oresk/multi_new/GFCI_sensor_pcb/PXL_20240924_142343800.jpg

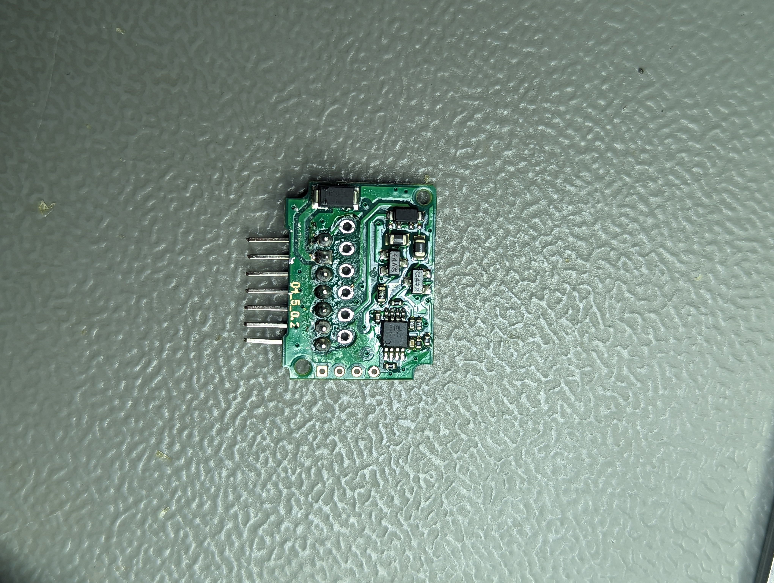
GFCI_sensor_pcb/PXL_20240924_142343800.jpg
