oresk/multi_new/GFCI_sensor_pcb/PXL_20240924_140607482.jpg

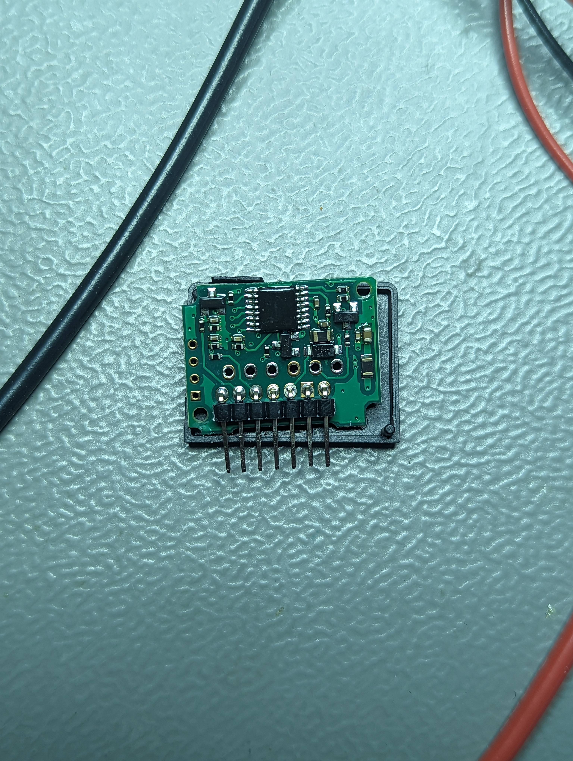
GFCI_sensor_pcb/PXL_20240924_140607482.jpg
