oresk/multi_new/GFCI_sensor_pcb/PXL_20240924_142329196.jpg

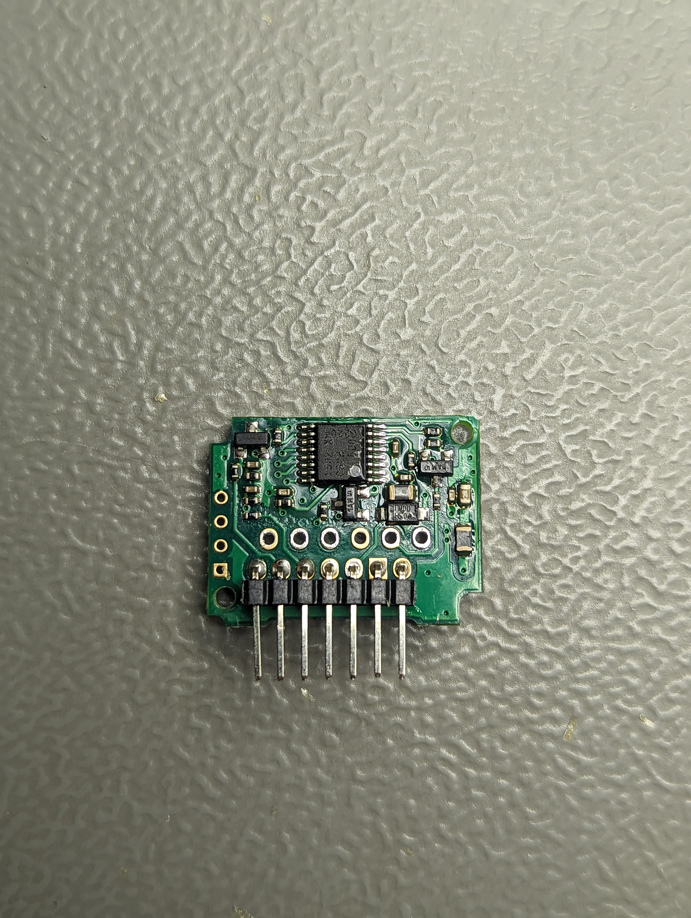
GFCI_sensor_pcb/PXL_20240924_142329196.jpg
