oresk/multi_new/code/hw_lower_v2/hw_lower_v2/hw_lower_v2.kicad_pcb

## KiCad design code/hw_lower_v2/hw_lower_v2/hw_lower_v2.kicad_pcb (2024-10-02)

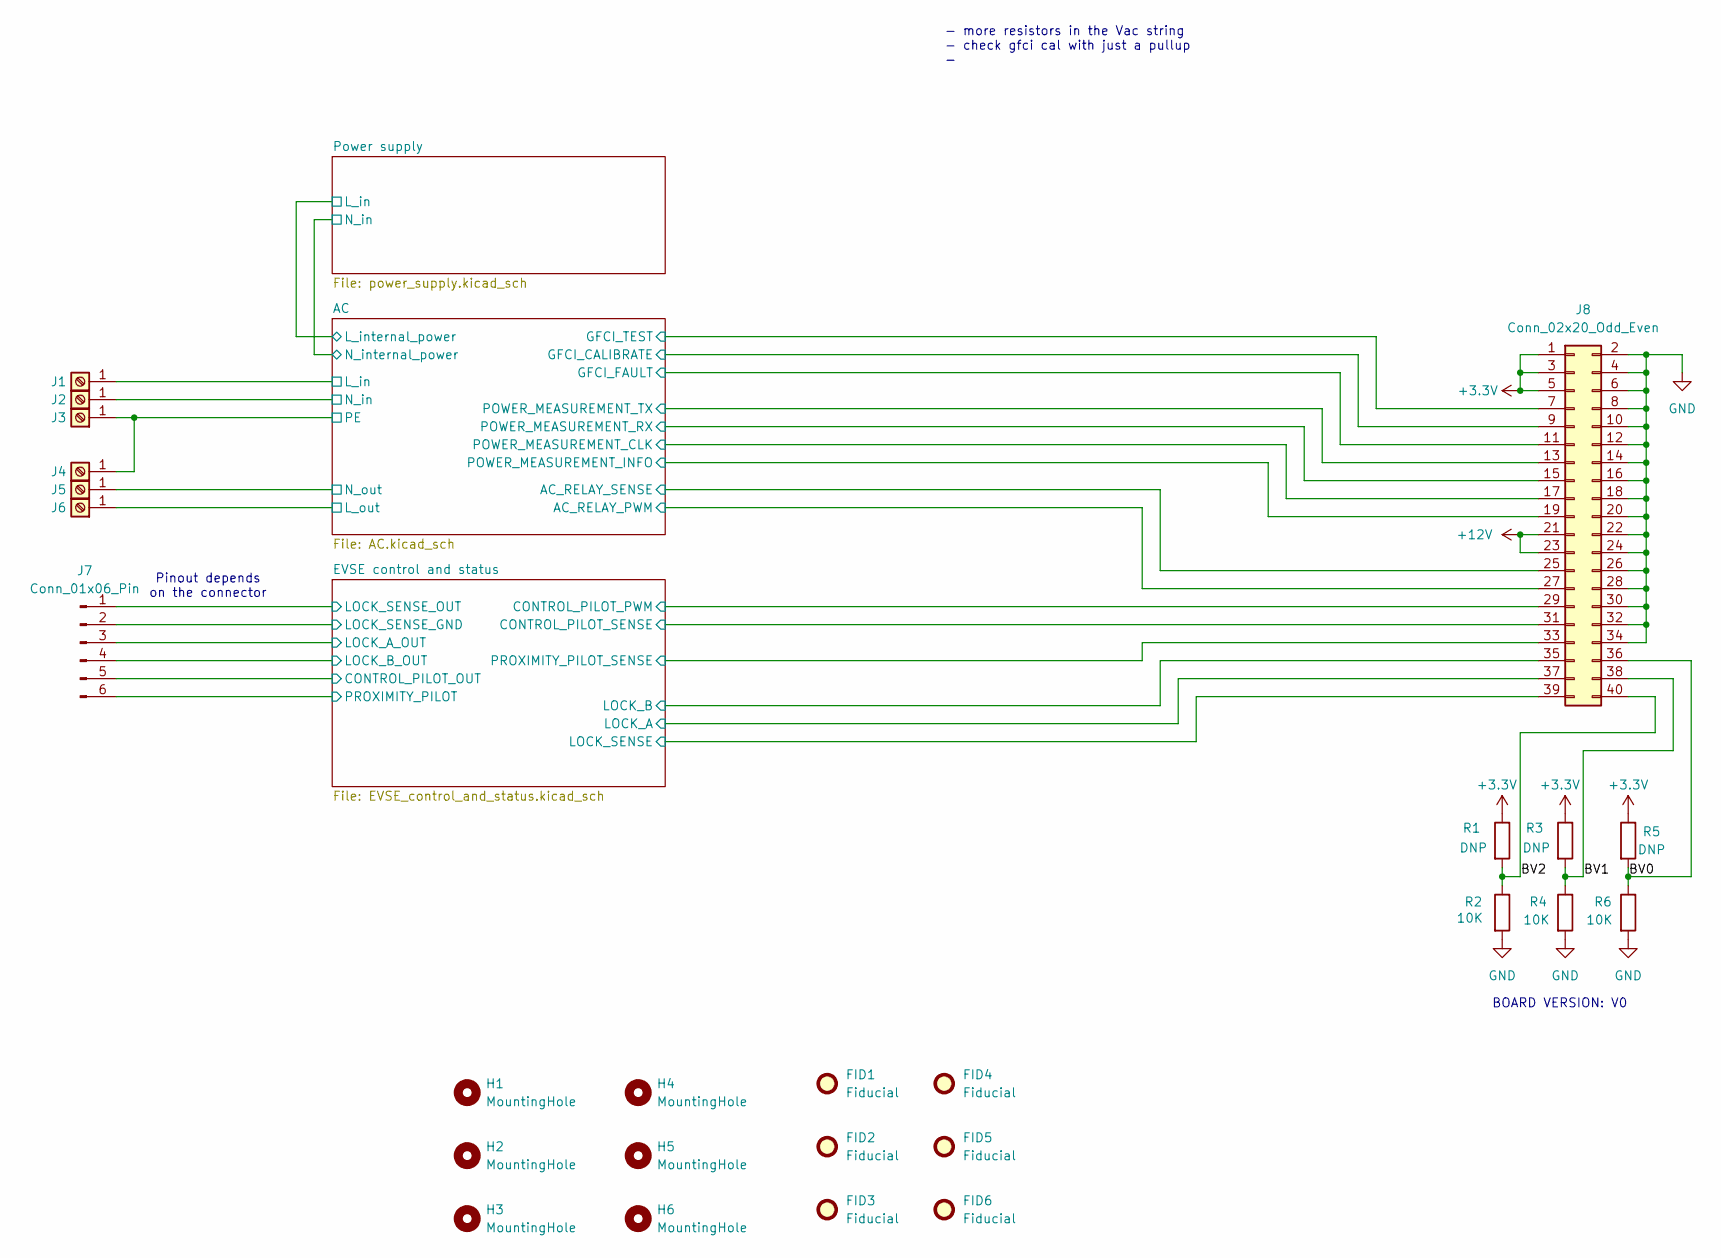
[picture p22: schematic hw_lower_v2.kicad_sch, BlueEVSE]

Parts:
FID1, FID2, FID3, FID4, FID5, FID6: Fiducial; Fiducial_1mm_Mask3mm
H1, H2: MountingHole; MountingHole_3.2mm_M3
H3, H4, H5, H6: MountingHole; MountingHole_3.2mm_M3_Pad
J1, J2, J3, J4, J5, J6: Screw_Terminal_01x01; CONN-TH_T44001; LCSC C481447
J7: Conn_01x06_Pin; PinHeader_1x06_P2.54mm_Horizontal; LCSC C56816
J8: Conn_02x20_Odd_Even; PinHeader_2x20_P2.54mm_Vertical
R1, R3, R5: DNP; R_0603_1608Metric
R2, R4, R6: 10K; R_0603_1608Metric; LCSC C25804

Connections:
+12V: J8.21, J8.23; also elsewhere on the board
/AC/AC_RELAY_PWM: J8.27; also elsewhere on the board
/AC/AC_RELAY_SENSE: J8.25; also elsewhere on the board
/AC/GFCI_CALIBRATE: J8.9; also elsewhere on the board
/AC/GFCI_FAULT: J8.11; also elsewhere on the board
/AC/GFCI_TEST: J8.7; also elsewhere on the board
/AC/L_in: J1.1; also elsewhere on the board
/AC/L_out: J6.1; also elsewhere on the board
/AC/N_in: J2.1; also elsewhere on the board
/AC/N_out: J5.1; also elsewhere on the board
/AC/POWER_MEASUREMENT_CLK: J8.17; also elsewhere on the board
/AC/POWER_MEASUREMENT_INFO: J8.19; also elsewhere on the board
/AC/POWER_MEASUREMENT_RX: J8.15; also elsewhere on the board
/AC/POWER_MEASUREMENT_TX: J8.13; also elsewhere on the board
/BV0: J8.36, R5.2, R6.1
/BV1: J8.38, R3.2, R4.1
/BV2: J8.40, R1.2, R2.1
/EVSE control and status/CONTROL_PILOT_OUT: J7.5; also elsewhere on the board
/EVSE control and status/CONTROL_PILOT_PWM: J8.29; also elsewhere on the board
/EVSE control and status/CONTROL_PILOT_SENSE: J8.31; also elsewhere on the board
/EVSE control and status/LOCK_A: J8.37; also elsewhere on the board
/EVSE control and status/LOCK_A_OUT: J7.3; also elsewhere on the board
/EVSE control and status/LOCK_B: J8.35; also elsewhere on the board
/EVSE control and status/LOCK_B_OUT: J7.4; also elsewhere on the board
/EVSE control and status/LOCK_SENSE: J7.1, J8.39; also elsewhere on the board
/EVSE control and status/PROXIMITY_PILOT: J7.6, J8.33; also elsewhere on the board
Earth_Protective: J3.1, J4.1

Notes on the sheet:
BOARD VERSION: V0
Pinout depends on the connector
- more resistors in the Vac string - check gfci cal with just a pullup -

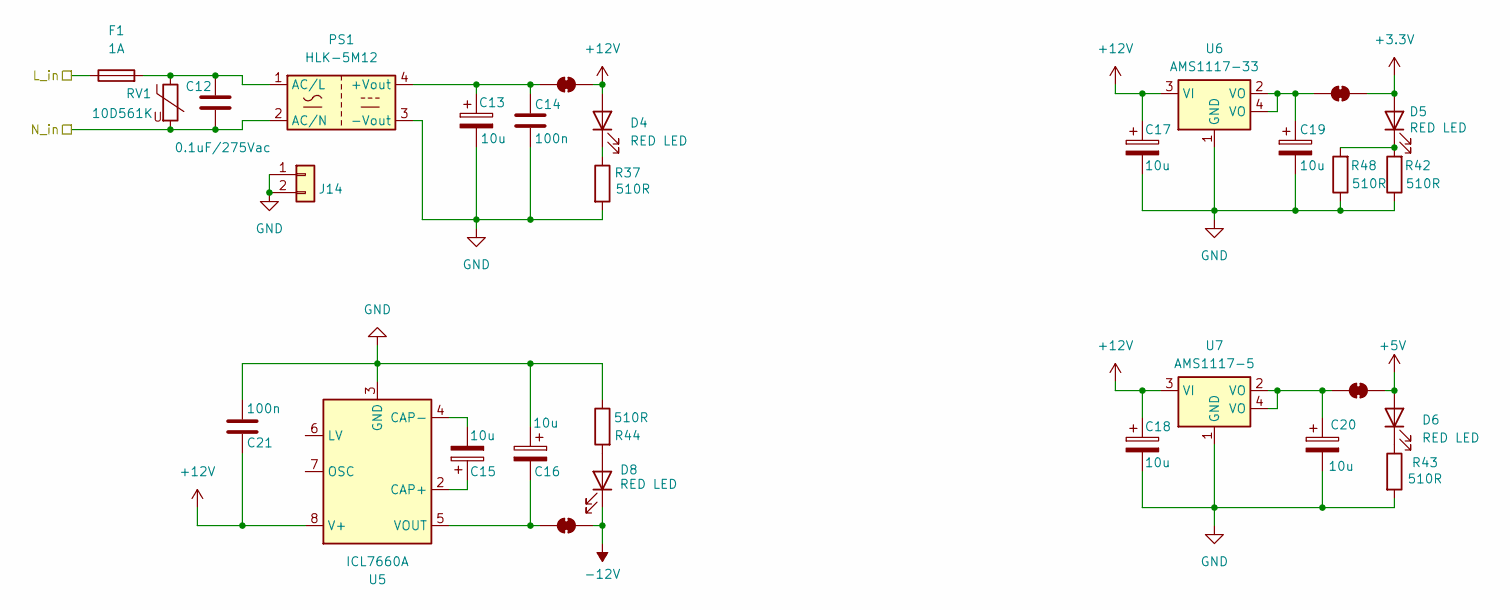
[picture p23: schematic power_supply.kicad_sch, BlueEVSE]

Parts:
C12: 0.1uF/275Vac; CAP-TH_L13.0-W6.0-P10.00-D0.6; LCSC C489079
C13, C15, C16, C17, C18, C19, C20: 10u; CP_Elec_4x5.4; LCSC C86602
C14, C21: 100n; C_0805_2012Metric; LCSC C327162
D4, D5, D6, D8: RED LED; D_0603_1608Metric; LCSC C7496820
F1: 1A; F1206; LCSC C910830
J14: Conn_01x02; PinHeader_1x02_P2.54mm_Vertical
JP1, JP3, JP4, JP5: SolderJumper_2_Bridged; SolderJumper-2_P1.3mm_Bridged2Bar_RoundedPad1.0x1.5mm
PS1: HLK-5M12; Converter_ACDC_Hi-Link_HLK-5Mxx; LCSC C209908
R37, R42, R43, R44, R48: 510R; R_0603_1608Metric; LCSC C23193
RV1: 10D561K; RES-TH_L12.5-W4.4-P7.50-D0.8-S3.60; LCSC C2761663
U5: ICL7660A; SOIC-8_L5.0-W4.0-P1.27-LS6.0-BL; LCSC C7881
U6: AMS1117-33; SOT-223_L6.7-W3.5-P2.30-BR; LCSC C6186
U7: AMS1117-5; SOT-223_L6.7-W3.5-P2.30-BR; LCSC C6187

Connections:
+12V: C17.1, C18.1, C21.1, D4.2 (A), JP1.1 (A), U5.8 (V+), U6.3 (VI), U7.3 (VI); also elsewhere on the board
/AC/L_internal_power: F1.1; also elsewhere on the board
/AC/N_internal_power: C12.2, PS1.2 (AC/N), RV1.2; also elsewhere on the board
unnamed: D4.1 (K), R37.1
unnamed: D5.1 (K), R42.2, R48.2
unnamed: D6.1 (K), R43.1
unnamed: D8.2 (A), R44.2
unnamed: C13.1, C14.1, JP1.2 (B), PS1.4 (+Vout)
unnamed: C16.2, JP3.2 (B), U5.5 (VOUT)
unnamed: C19.1, JP4.2 (B), U6.2 (VO), U6.4 (VO)
unnamed: C20.1, JP5.2 (B), U7.2 (VO), U7.4 (VO)
unnamed: C12.1, F1.2, PS1.1 (AC/L), RV1.1
unnamed: C15.1, U5.2 (CAP+)
unnamed: C15.2, U5.4 (CAP-)

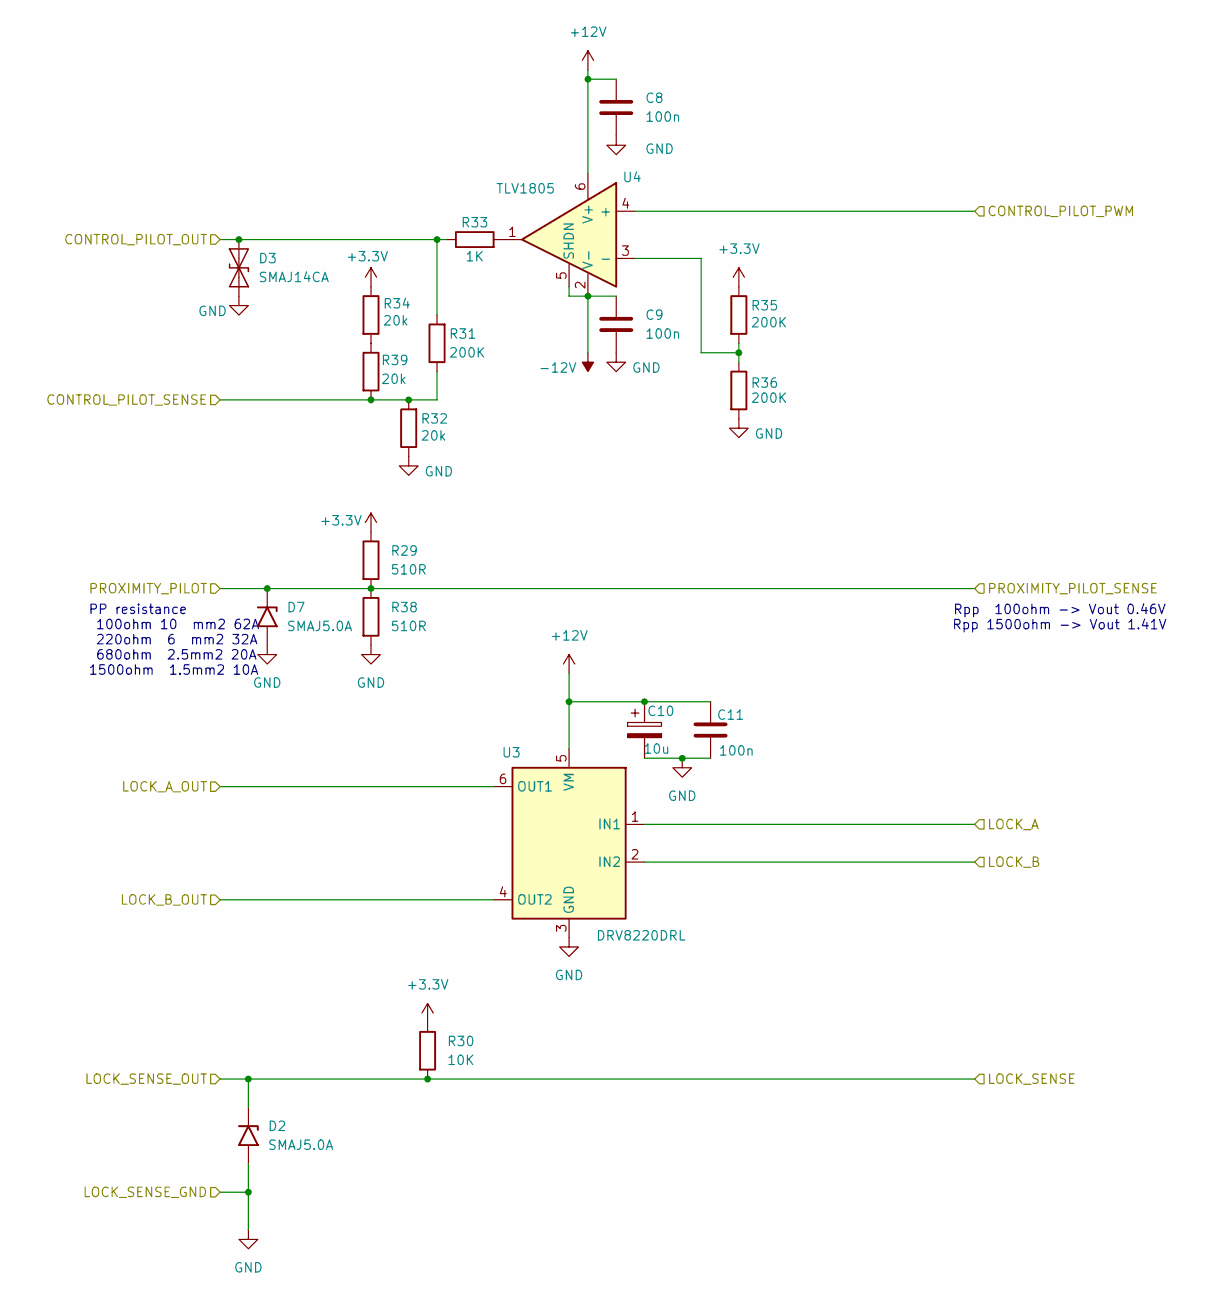
[picture p24: schematic EVSE_control_and_status.kicad_sch, BlueEVSE]

Parts:
C8, C9, C11: 100n; C_0805_2012Metric; LCSC C327162
C10: 10u; CP_Elec_4x5.4; LCSC C86602
D2, D7: SMAJ5.0A; D_SMA; LCSC C7473307
D3: SMAJ14CA; D_SMA; LCSC C908820
R29, R38: 510R; R_0603_1608Metric; LCSC C23193
R30: 10K; R_0603_1608Metric; LCSC C25804
R31, R35, R36: 200K; R_0603_1608Metric; LCSC C2989567
R32, R34, R39: 20k; R_0603_1608Metric
R33: 1K; R_0603_1608Metric
U3: DRV8220DRL; SOT-563; LCSC C3681351
U4: TLV1805; SOT-23-6_L2.9-W1.6-P0.95-LS2.8-BR; LCSC C2862164

Connections:
+12V: C8.1, C10.1, C11.1, U3.5 (VM), U4.6 (V+); also elsewhere on the board
/EVSE control and status/CONTROL_PILOT_OUT: D3.2 (A2), R31.2, R33.1; also elsewhere on the board
/EVSE control and status/CONTROL_PILOT_PWM: U4.4 (+); also elsewhere on the board
/EVSE control and status/CONTROL_PILOT_SENSE: R31.1, R32.2, R39.2; also elsewhere on the board
/EVSE control and status/LOCK_A: U3.1 (IN1); also elsewhere on the board
/EVSE control and status/LOCK_A_OUT: U3.6 (OUT1); also elsewhere on the board
/EVSE control and status/LOCK_B: U3.2 (IN2); also elsewhere on the board
/EVSE control and status/LOCK_B_OUT: U3.4 (OUT2); also elsewhere on the board
/EVSE control and status/LOCK_SENSE: D2.1 (A1), R30.2; also elsewhere on the board
/EVSE control and status/PROXIMITY_PILOT: D7.1 (A1), R29.2, R38.1; also elsewhere on the board
unnamed: R33.2, U4.1
unnamed: R34.2, R39.1
unnamed: R35.2, R36.1, U4.3 (-)

Notes on the sheet:
PP resistance 100ohm 10 mm2 62A 220ohm 6 mm2 32A 680ohm 2.5mm2 20A 1500ohm 1.5mm2 10A
Rpp 100ohm -> Vout 0.46V Rpp 1500ohm -> Vout 1.41V

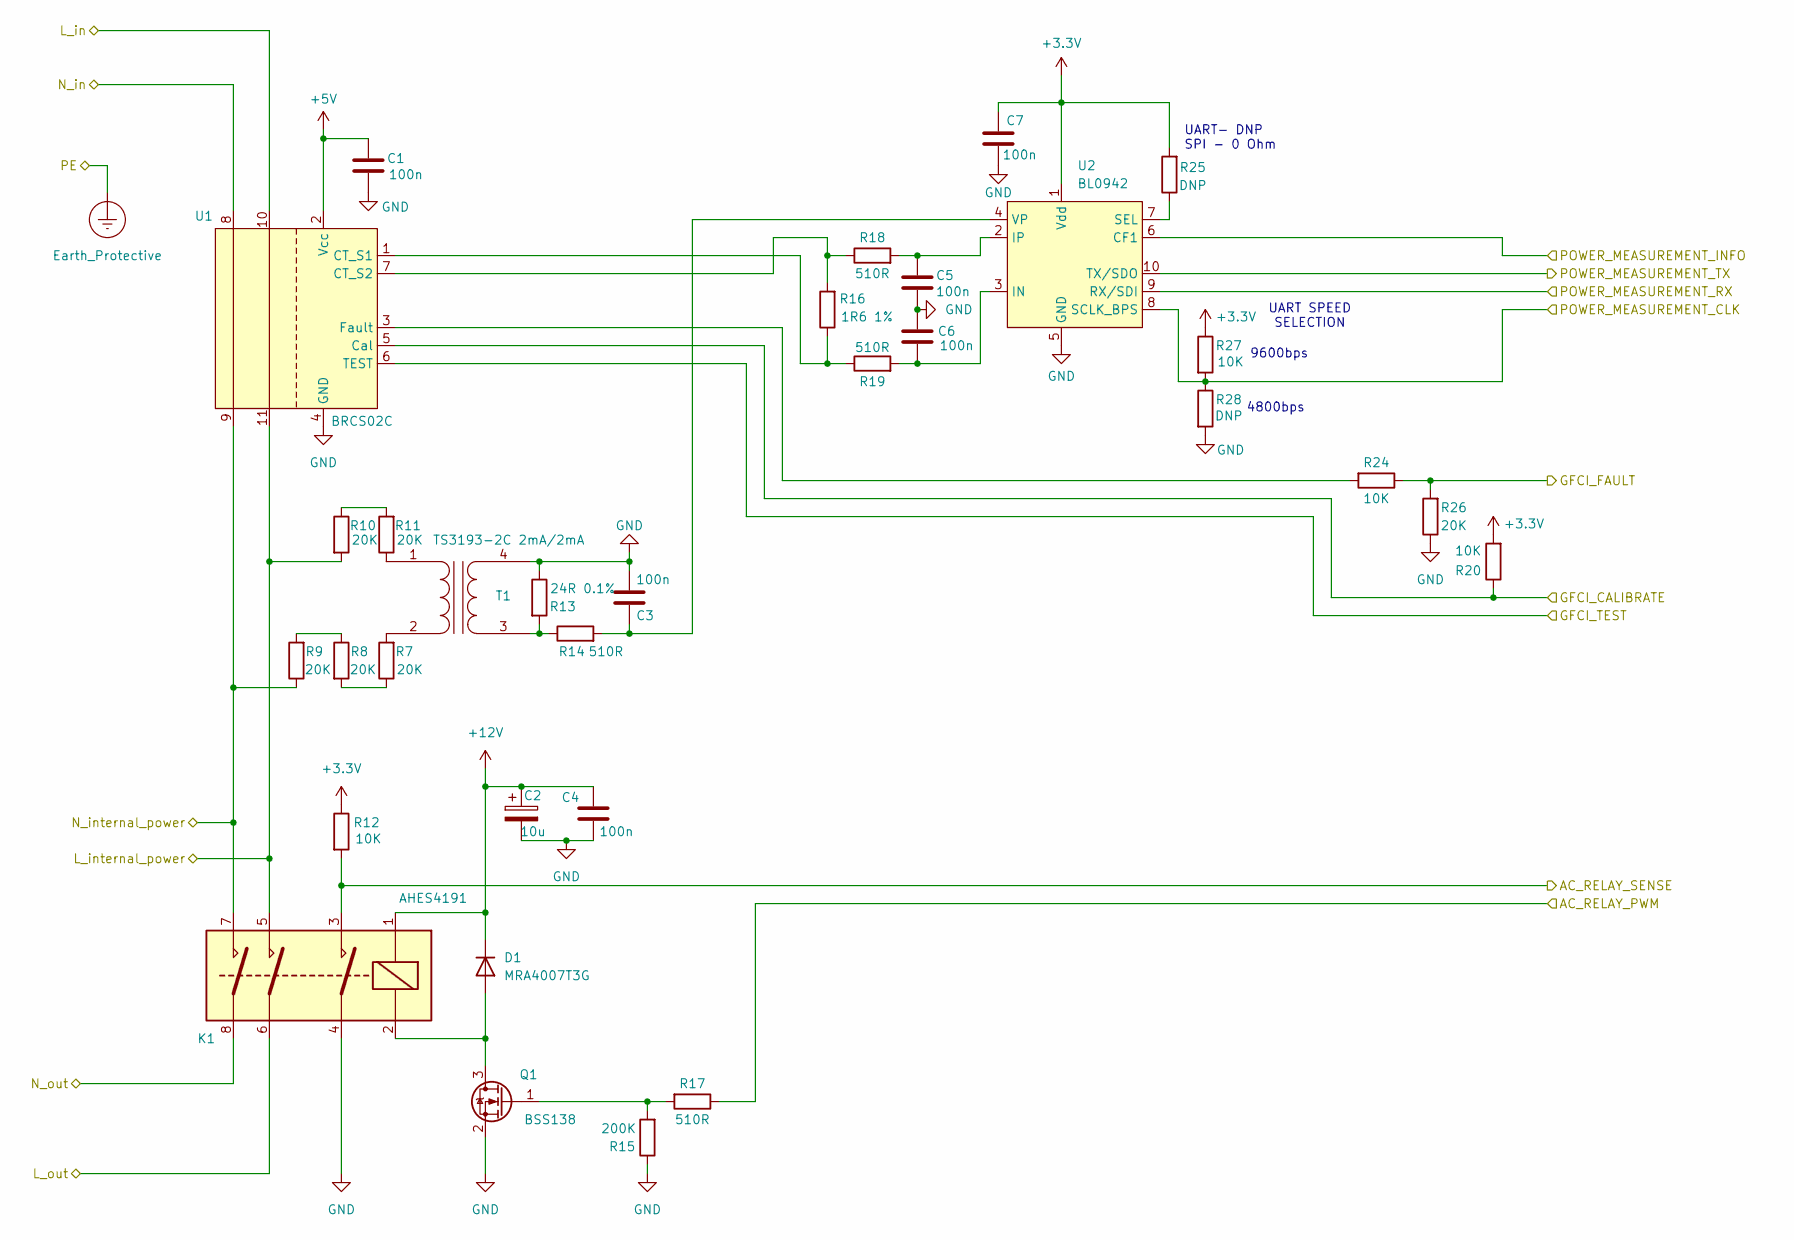
[picture p25: schematic AC.kicad_sch, BlueEVSE]

Parts:
C1, C3, C4, C5, C6, C7: 100n; C_0805_2012Metric; LCSC C327162
C2: 10u; CP_Elec_4x5.4; LCSC C86602
D1: MRA4007T3G; D_SMA; LCSC C47921
K1: AHES4191; panasonic HE-s; LCSC C719192
Q1: BSS138; SOT-23; LCSC C112239
R7, R8, R9, R10, R11, R26: 20K; R_1206_3216Metric; LCSC C706407
R12, R20, R24, R27: 10K; R_0603_1608Metric; LCSC C25804
R13: 24R 0.1%; R_0603_1608Metric; LCSC C317933
R14, R17, R18, R19: 510R; R_0603_1608Metric; LCSC C23193
R15: 200K; R_0603_1608Metric; LCSC C2989567
R16: 1R6 1%; R_0603_1608Metric; LCSC C365113
R25, R28: DNP; R_0603_1608Metric
T1: TS3193-2C 2mA/2mA; TS3193-2C; LCSC C2896606
U1: BRCS02C; BRCS02C_2
U2: BL0942; SSOP-10_L4.9-W3.9-P1.00-LS6.0-BL; LCSC C2837510

Connections:
+12V: C2.1, C4.1, D1.1 (K), K1.1; also elsewhere on the board
/AC/AC_RELAY_PWM: R17.1; also elsewhere on the board
/AC/AC_RELAY_SENSE: K1.3, R12.2; also elsewhere on the board
/AC/GFCI_FAULT: R24.1, R26.2; also elsewhere on the board
/AC/L_in: U1.10; also elsewhere on the board
/AC/L_internal_power: K1.5, R10.2, U1.11; also elsewhere on the board
/AC/L_out: K1.6; also elsewhere on the board
/AC/N_in: U1.8; also elsewhere on the board
/AC/N_internal_power: K1.7, R9.1, U1.9; also elsewhere on the board
/AC/N_out: K1.8; also elsewhere on the board
/AC/POWER_MEASUREMENT_CLK: R27.2, R28.1, U2.8 (SCLK_BPS); also elsewhere on the board
/AC/POWER_MEASUREMENT_INFO: U2.6 (CF1); also elsewhere on the board
/AC/POWER_MEASUREMENT_RX: U2.9 (RX/SDI); also elsewhere on the board
/AC/POWER_MEASUREMENT_TX: U2.10 (TX/SDO); also elsewhere on the board
unnamed: D1.2 (A), K1.2, Q1.3 (D)
unnamed: Q1.1 (G), R15.2, R17.2
unnamed 40: R20.1, U1.5 (Cal); also elsewhere on the board
unnamed 41: U1.6 (TEST); also elsewhere on the board
unnamed 42: R7.1, R8.2; also elsewhere on the board
unnamed 43: R8.1, R9.2; also elsewhere on the board
unnamed 44: R10.1, R11.2; also elsewhere on the board
unnamed 47: R11.1, T1.1 (AA); also elsewhere on the board
unnamed 48: R7.2, T1.2 (AB); also elsewhere on the board
unnamed: R13.2, R14.1, T1.3 (SA)
unnamed: R16.1, R19.1, U1.1 (CT_S1)
unnamed: R16.2, R18.1, U1.7 (CT_S2)
unnamed: R24.2, U1.3 (Fault)
unnamed: C6.2, R19.2, U2.3 (IN)
unnamed: C5.1, R18.2, U2.2 (IP)
unnamed: R25.1, U2.7 (SEL)
unnamed: C3.1, R14.2, U2.4 (VP)

Notes on the sheet:
4800bps
UART SPEED SELECTION
UART- DNP SPI - 0 Ohm
9600bps

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
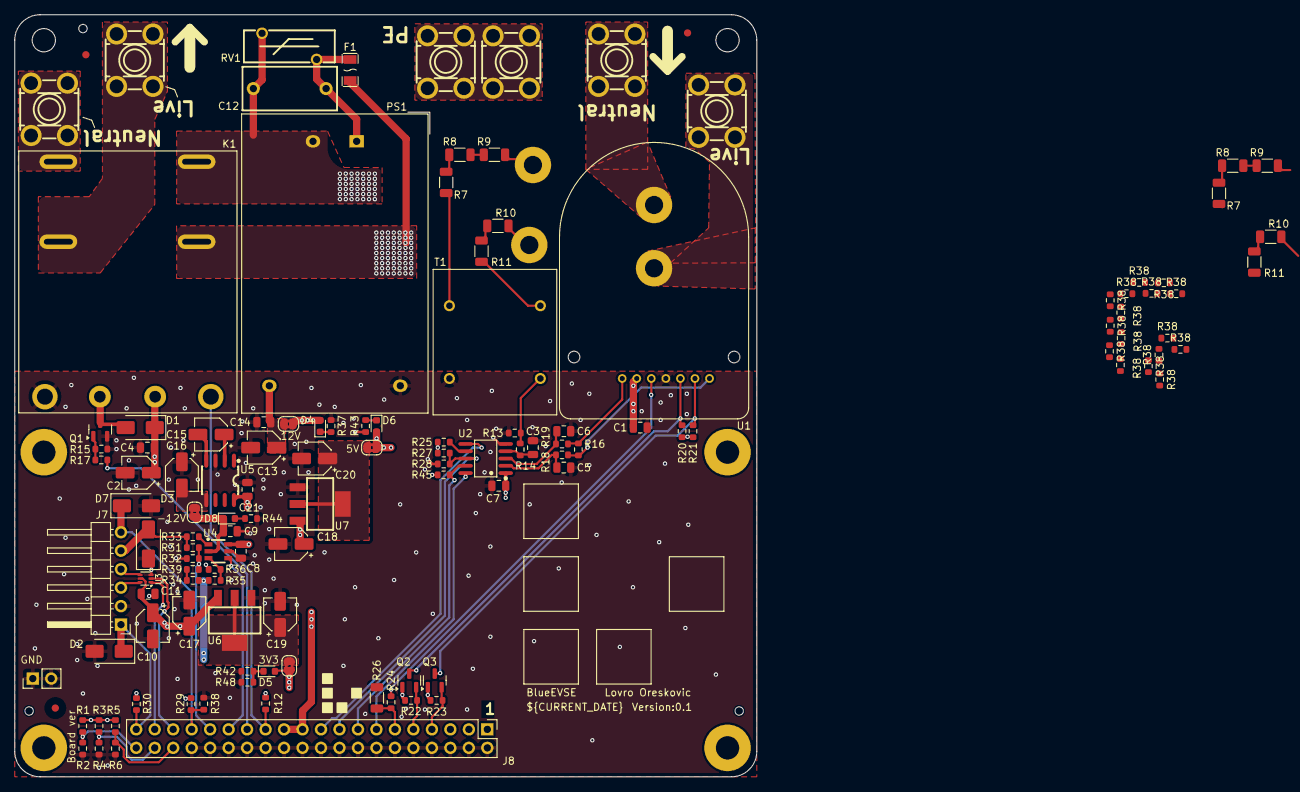
[picture p26: board hw_lower_v2.kicad_pcb from above]

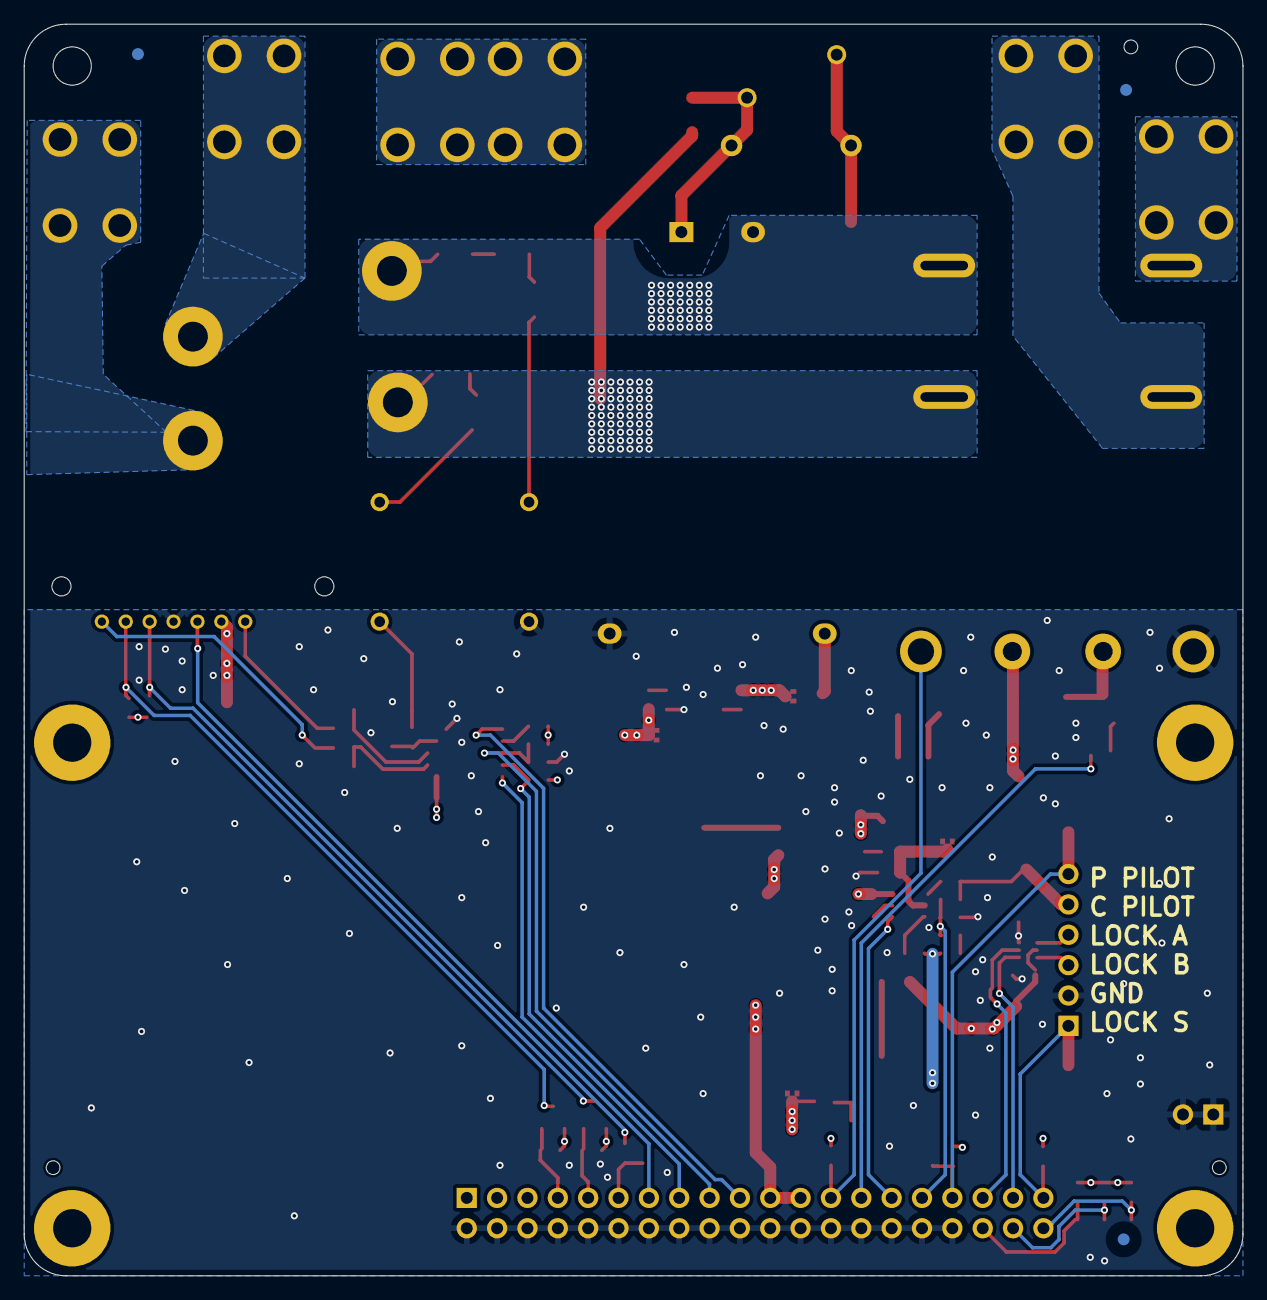
[picture p27: board hw_lower_v2.kicad_pcb from below]

Board: 4 copper layers, 102.0 x 104.8 mm, 134 parts (3 on the bottom side), 64 nets.

Other parts of the board:
Q2, Q3: BSS138; SOT-23
R7#2, R8#2, R9#2, R10#2, R11#2: 20K; R_1206_3216Metric
R21, R22, R23, R45: 10K; R_0603_1608Metric
R38#2, R38#3, R38#4, R38#5, R38#6, R38#7, R38#8, R38#9, R38#10, R38#11, R38#12, R38#13, R38#14, R38#15, R38#16, R38#17: 510R; R_0603_1608Metric

Their connections:
/AC/GFCI_CALIBRATE: Q2.2 (S), R22.1; also elsewhere on the board
/AC/GFCI_TEST: Q3.2 (S), R23.1; also elsewhere on the board
/AC/L_internal_power: R10#2.2; also elsewhere on the board
/AC/N_internal_power: R9#2.1; also elsewhere on the board
/AC/POWER_MEASUREMENT_RX: R45.2; also elsewhere on the board
/EVSE control and status/PROXIMITY_PILOT: R38#14.1; also elsewhere on the board
unnamed 40: Q2.3 (D); also elsewhere on the board
unnamed 41: Q3.3 (D), R21.1; also elsewhere on the board
unnamed 42: R7#2.1, R8#2.2; also elsewhere on the board
unnamed 43: R8#2.1, R9#2.2; also elsewhere on the board
unnamed 44: R10#2.1, R11#2.2; also elsewhere on the board
unnamed 47: R11#2.1; also elsewhere on the board
unnamed 48: R7#2.2; also elsewhere on the board
