oresk/multi_new/(commit log)

2024-05-23 initial commit with a bunch of notes
    [hw_lower_v1.kicad_pcb, hw_lower_v1.kicad_sch]
2024-06-01 general outline of the lower board schematic
2024-06-01 add kicad gitignore
    [hw_lower_v1.kicad_sch]
2024-06-01 add .gitignore for kicad
2024-07-14 started full lower pcb version
    [hw_lower_v1.kicad_sch]
2024-07-17 hierarcyhal sheets
    [AC.kicad_sch, EVSE_control_and_status.kicad_sch, hw_lower_v2.kicad_pcb, hw_lower_v2.kicad_sch, hw_upper_v1.kicad_pcb, hw_upper_v1.kicad_sch, power_supply.kicad_sch]
2024-07-18 further lower board sch work
    [AC.kicad_sch, EVSE_control_and_status.kicad_sch, hw_lower_v2.kicad_pcb, hw_lower_v2.kicad_sch, power_supply.kicad_sch]
2024-07-20 add 12V voltage inverter and polish
    [AC.kicad_sch, EVSE_control_and_status.kicad_sch, hw_lower_v2.kicad_sch, power_supply.kicad_sch]
2024-07-22 schematic is done
    [AC.kicad_sch, EVSE_control_and_status.kicad_sch, hw_lower_v2.kicad_sch, power_supply.kicad_sch]
2024-07-23 finishing up sch and creating footprints
    [AC.kicad_sch, EVSE_control_and_status.kicad_sch, hw_lower_v2.kicad_sch, power_supply.kicad_sch]
2024-07-25 finished schematic, started first pass of layout
    [AC.kicad_sch, EVSE_control_and_status.kicad_sch, hw_lower_v2.kicad_pcb, hw_lower_v2.kicad_sch, power_supply.kicad_sch]
2024-07-25 Preliminary pcb component placement done
    PCB size currently is around 100mm X 100mm with the mezanine board being ~40mm x 100mm
    [AC.kicad_sch, EVSE_control_and_status.kicad_sch, hw_lower_v2.kicad_pcb, power_supply.kicad_sch]
2024-07-28 grouped and positioned components
    [AC.kicad_sch, hw_lower_v2.kicad_pcb]
2024-07-28 further placement and pin relocation
    [AC.kicad_sch, hw_lower_v2.kicad_pcb, hw_lower_v2.kicad_sch, hw_upper_v1.kicad_pcb, hw_upper_v1.kicad_sch]
2024-07-28 commit before experimenting
    [AC.kicad_sch, hw_lower_v2.kicad_pcb, hw_lower_v2.kicad_sch]
2024-07-29 switch power pin headers for jumpers
    [hw_lower_v2.kicad_pcb, power_supply.kicad_sch]
2024-07-29 have one project part library
    [AC.kicad_sch, EVSE_control_and_status.kicad_sch, hw_lower_v2.kicad_pcb, hw_lower_v2.kicad_sch, hw_upper_v1.kicad_pcb, power_supply.kicad_sch]
2024-07-29 add kicad lock files to git ignore
2024-07-29 right before tracks
    [AC.kicad_sch, hw_lower_v2.kicad_pcb]
2024-07-30 routed most of the board
    [hw_lower_v2.kicad_pcb, hw_lower_v2.kicad_sch]
2024-08-06 before the final route
    [hw_lower_v2.kicad_pcb, hw_upper_v1.kicad_pcb]
2024-08-06 layout 99% finished
    [hw_lower_v2.kicad_pcb, hw_lower_v2.kicad_sch]
2024-08-07 finish 3d models
    [hw_lower_v2.kicad_pcb, power_supply.kicad_sch]
2024-08-07 moved stuff around a little bit, will optimise the number of components now
    [AC.kicad_sch, hw_lower_v2.kicad_pcb, hw_upper_v1.kicad_pcb]
2024-08-08 simplify component values
    [AC.kicad_sch, EVSE_control_and_status.kicad_sch, hw_lower_v2.kicad_pcb, hw_lower_v2.kicad_sch, power_supply.kicad_sch]
2024-08-08 made a full reposition of the whole pcb. When I get everything working, the milkv module can be on the bottom pcb and all the device specific devices can be on the other pcb. Also now conceptualy, th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
    [AC.kicad_sch, hw_lower_v2.kicad_pcb, hw_lower_v2.kicad_sch, power_supply.kicad_sch]
2024-08-09 Relalaid out the LV part of the board.
    One or two small things left to do.
    Prepared for the 2.0 version of the PCB where the duo01 module can be
    put on the lower board.
    Also it is possible to make a sandwitch situation, and make a long thin
    product.
    [hw_lower_v2.kicad_pcb, hw_lower_v2.kicad_sch]
2024-08-09 almost ready :-)
    [hw_lower_v2.kicad_pcb, hw_lower_v2.kicad_sch]
2024-08-09 add JLCPCB tooling holes and simplify further
    [AC.kicad_sch, EVSE_control_and_status.kicad_sch, hw_lower_v2.kicad_pcb, hw_lower_v2.kicad_sch, power_supply.kicad_sch]
2024-08-15 clean up old files
    [AC.kicad_sch, hw_lower_v1.kicad_pcb, hw_lower_v1.kicad_sch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]
